yry-dev/card-scanner/card-scanner-base.png

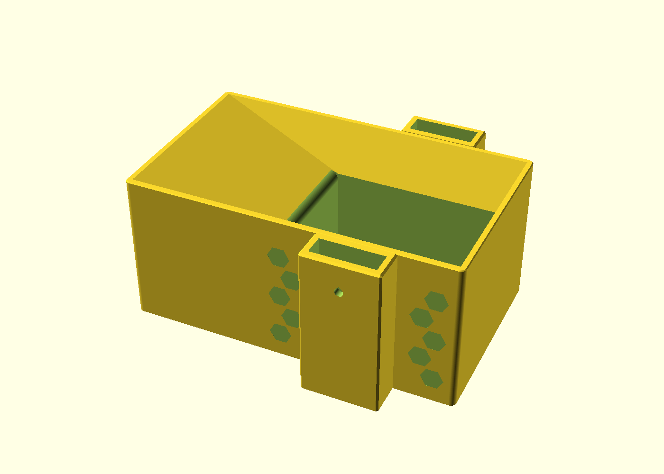
card-scanner-base.png
