yry-dev/card-scanner/card-scanner-pillar.png

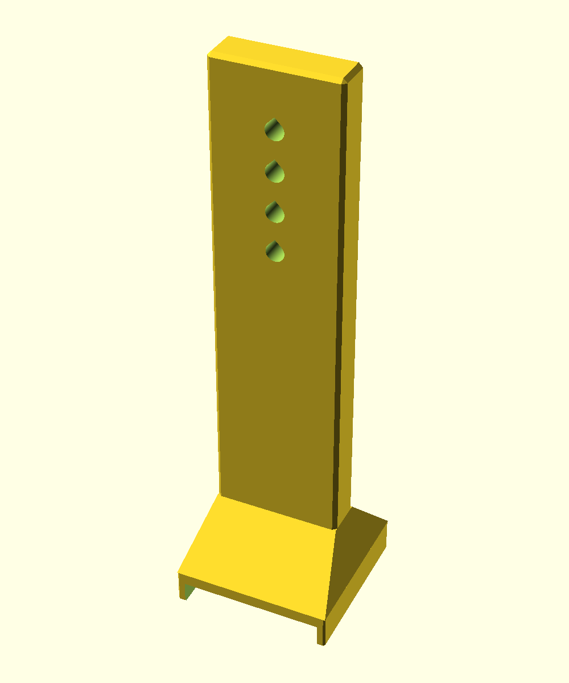
card-scanner-pillar.png
