yry-dev/card-scanner/card-scanner-pin.png

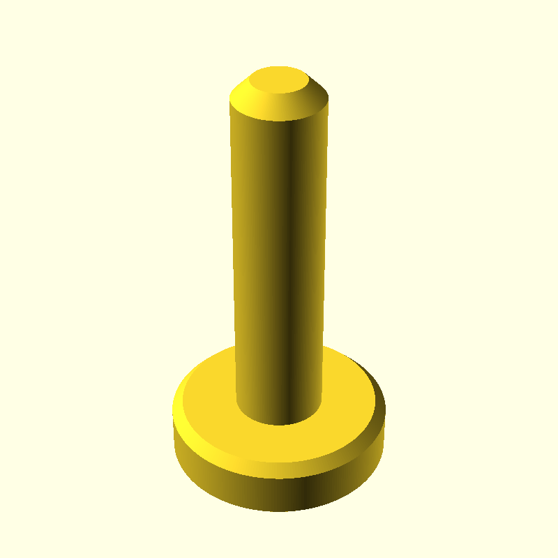
card-scanner-pin.png
