yry-dev/card-scanner/card-scanner-plate.png

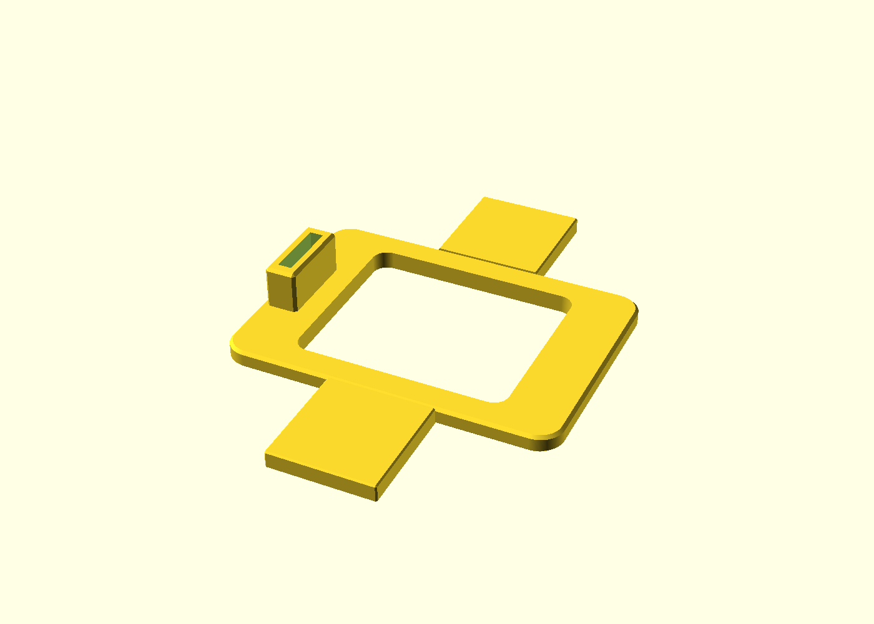
card-scanner-plate.png
